APLUX-Official/kame_robot/image1.png

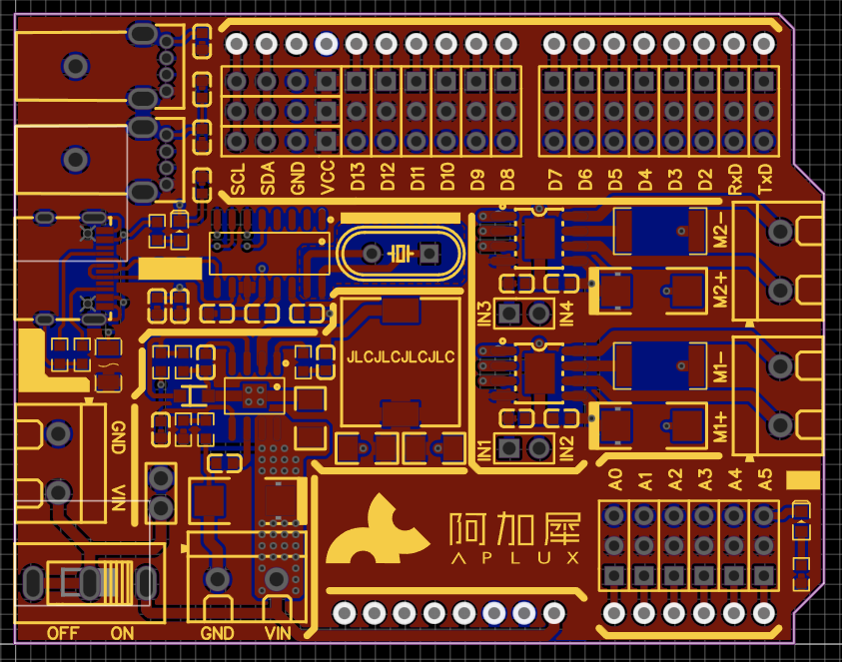
image1.png
