APLUX-Official/kame_robot/image2.png

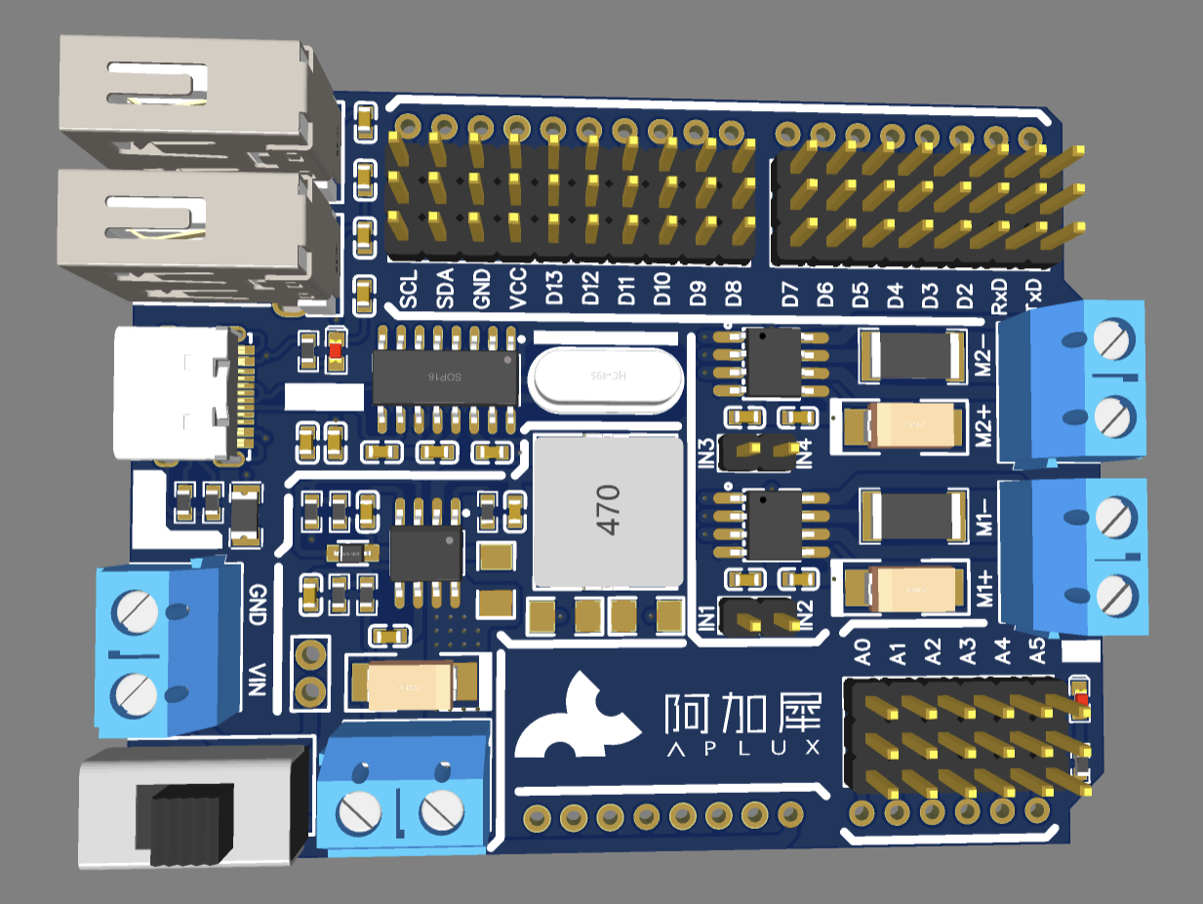
image2.png
