APLUX-Official/kame_robot/models/关节1.STL

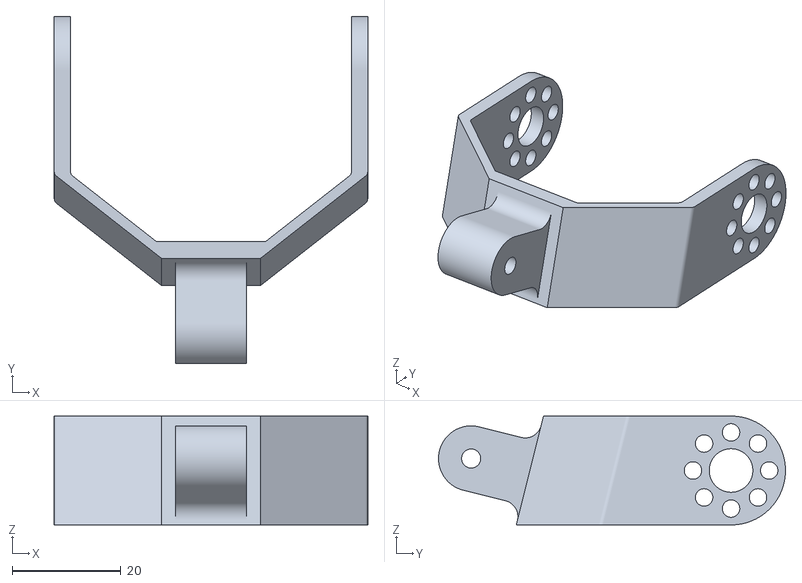
[picture p3: CAD file, 2026-03-10]
models/关节1.STL
57.6 x 63.8 x 20.0
