APLUX-Official/kame_robot/models/关节2.STL

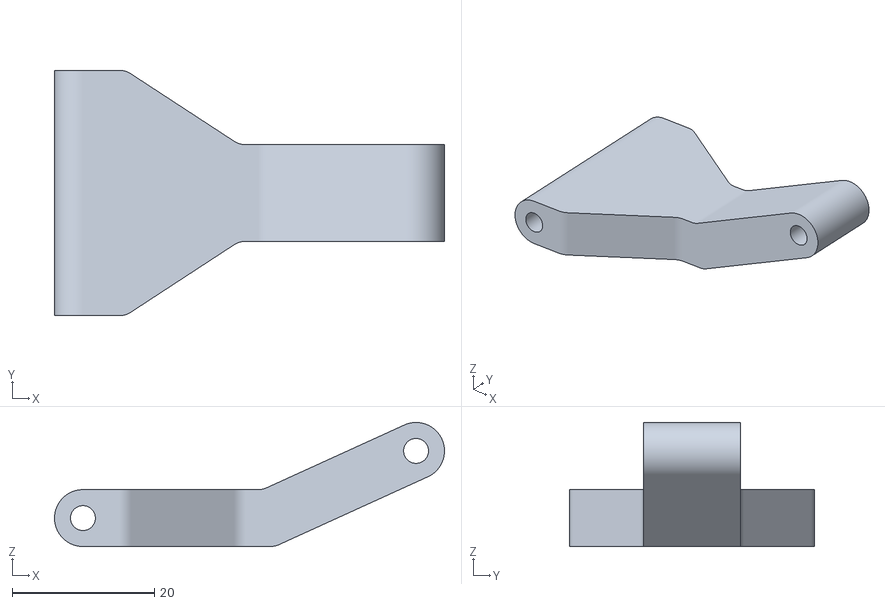
[picture p4: CAD file, 2026-03-10]
models/关节2.STL
54.9 x 34.5 x 17.4
