APLUX-Official/kame_robot/models/盖.STL

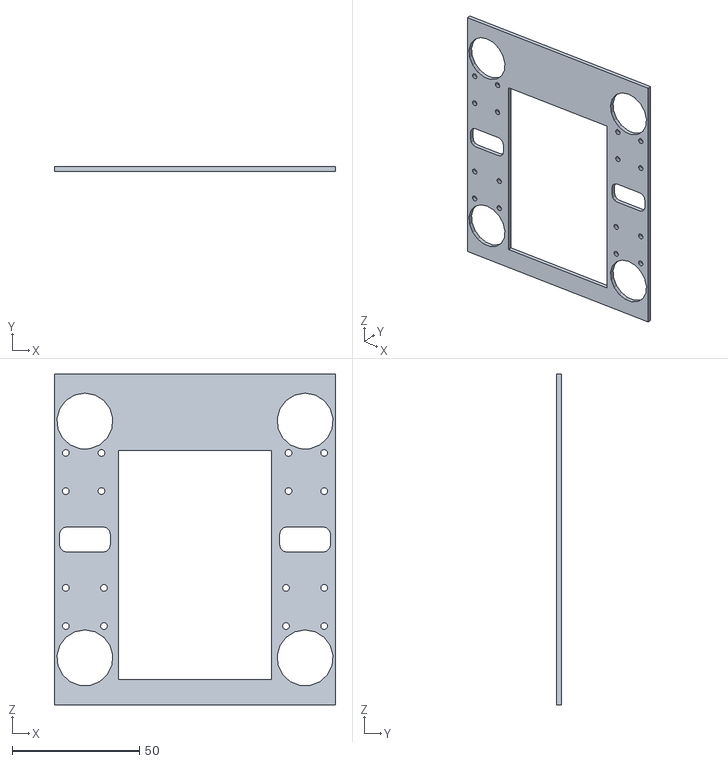
[picture p5: CAD file, 2026-03-10]
models/盖.STL
110.5 x 2.00 x 130.0
