APLUX-Official/kame_robot/models/小四足脚 - 3.STL

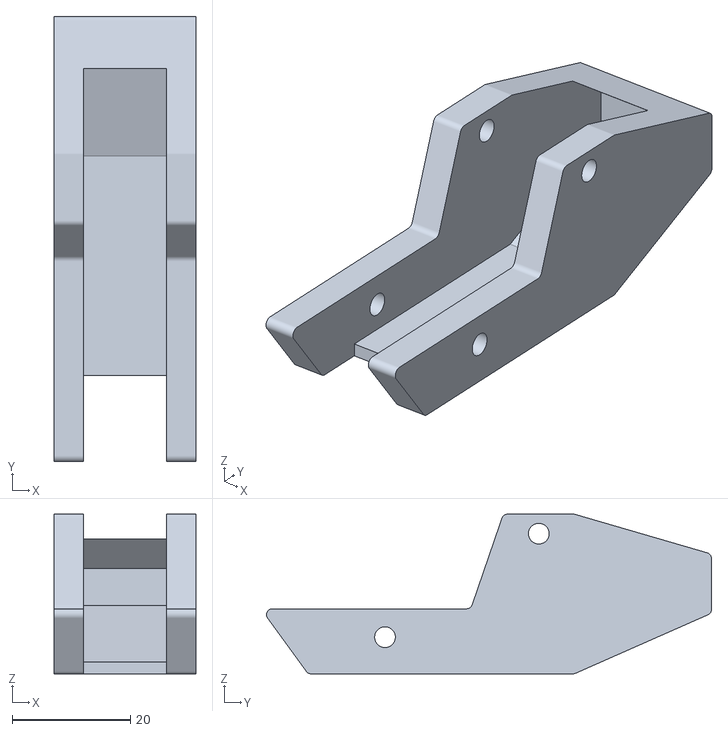
[picture p6: CAD file, 2026-03-10]
models/小四足脚 - 3.STL
24.0 x 75.2 x 27.0
