APLUX-Official/kame_robot/Schematic_2026-03-10.pdf

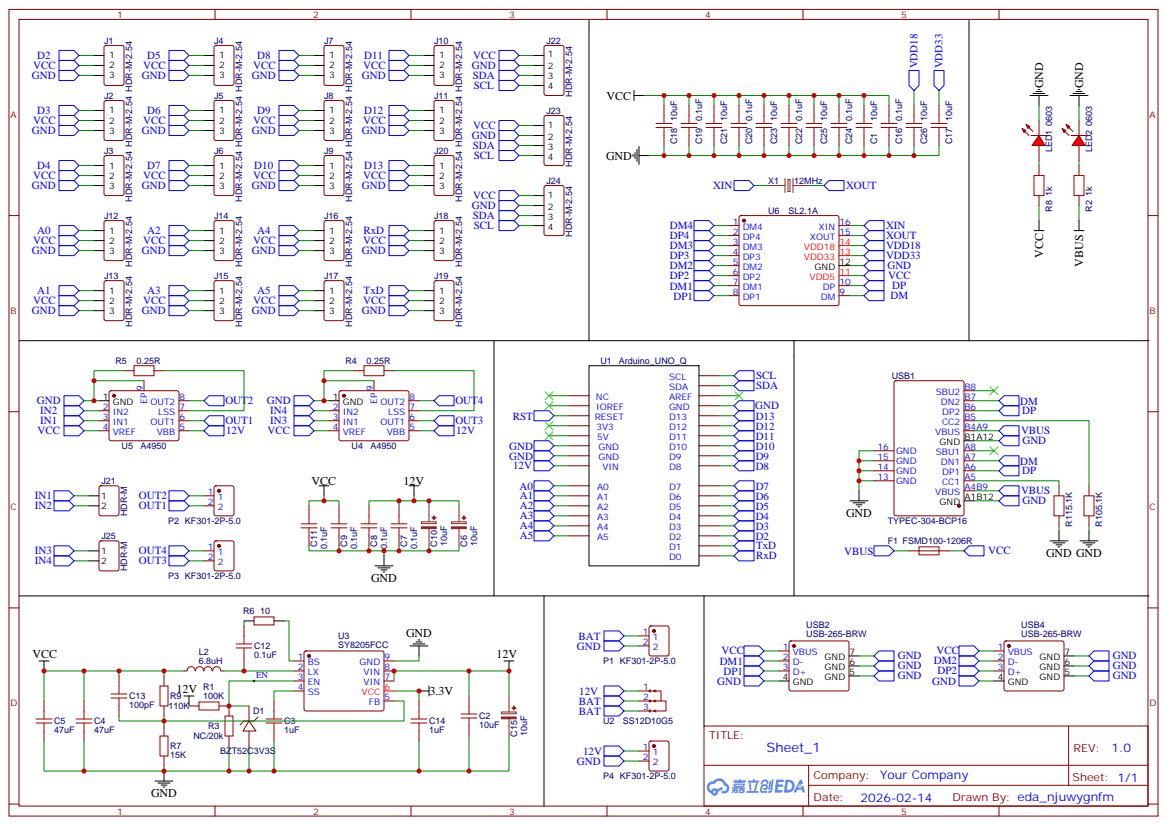
[picture p7: page 1]

DP 10 VDD5 11 GND 12 VDD33 13 VDD18 14 XOUT 15 XIN 16
