APLUX-Official/kame_robot/(commit log)

2026-03-06 修改步数和周期同时最值的情况下出现的无法操作问题
2026-03-10 add models/schematic
    [关节1.STL, 关节2.STL, 小四足脚 - 3.STL, 盖.STL]
